lime7git/sun-follower/README.md

# sun-follower
 Academical project of sun follower based on Raspberry Pi Pico.
 
