lime7git/sun-follower/docs/links.txt

Ogniwo słoneczne - https://botland.com.pl/panele-sloneczne-malej-mocy/3695-ogniwo-sloneczne-07w55v-95x95x3mm.html

95x95x3 mm
0.7 W
5.5 V

https://botland.com.pl/serwa-typu-medium/2303-serwo-powerhd-hd-1160a-medium-6953524540047.html
