lime7git/sun-follower/3d-model/renders/1.JPG

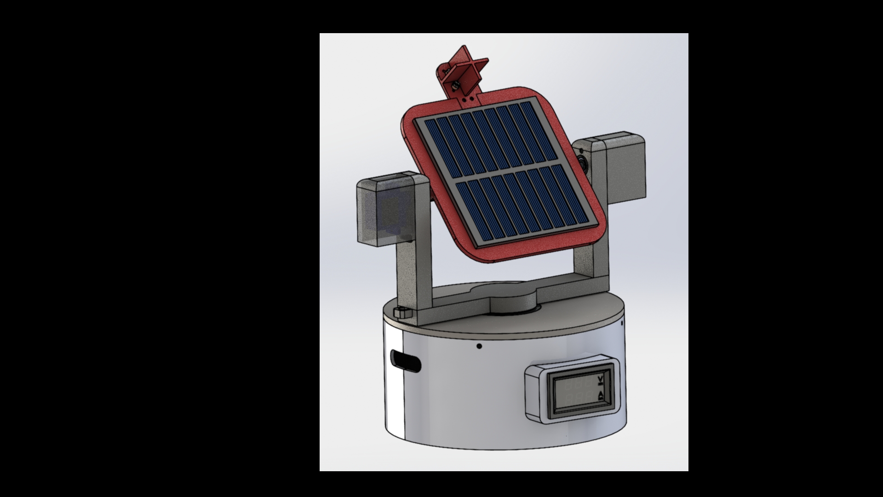
3d-model/renders/1.JPG
