lime7git/sun-follower/3d-model/renders/3.JPG

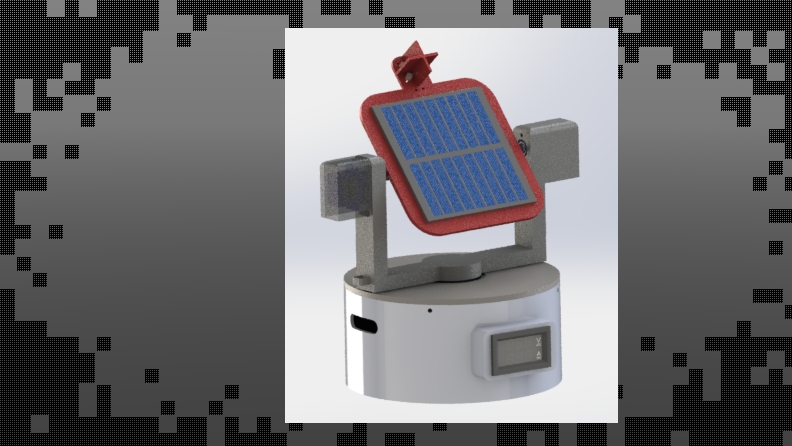
3d-model/renders/3.JPG
