lime7git/sun-follower/docs/adc-multiplexing-circuit.png

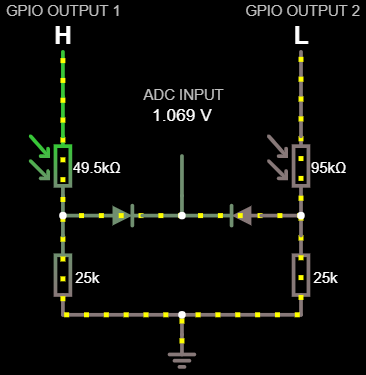
docs/adc-multiplexing-circuit.png
