lime7git/sun-follower/photos/komplet.jpg

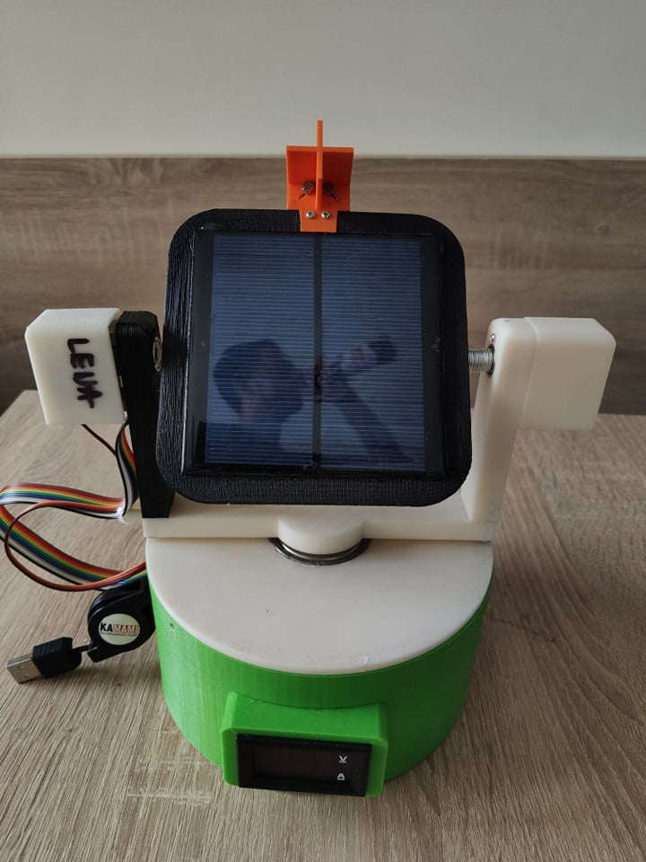
photos/komplet.jpg
