lime7git/sun-follower/photos/kompletny_2.jpg

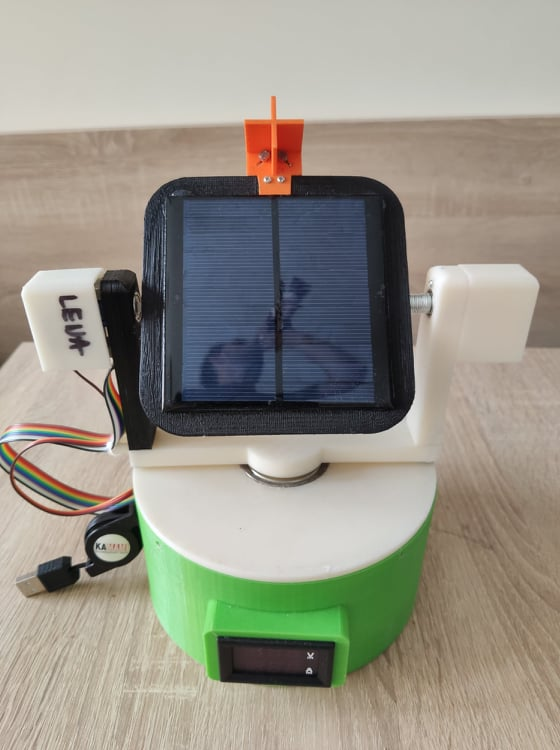
photos/kompletny_2.jpg
