lime7git/sun-follower/3d-model/ramie_prawe.SLDPRT

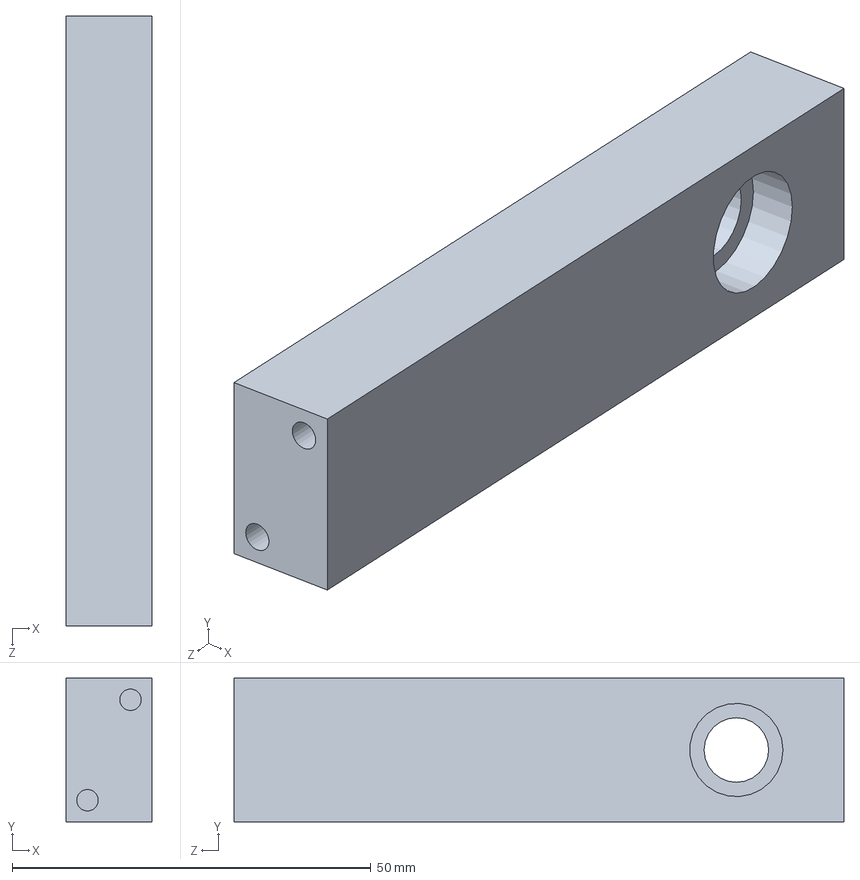
[picture p35: CAD file, 2022-02-01]
3d-model/ramie_prawe.SLDPRT
12.0 x 20.0 x 85.0 mm
