lime7git/sun-follower/3d-model/3d-printing-stl/Nowy folder/walek_lewy.STL

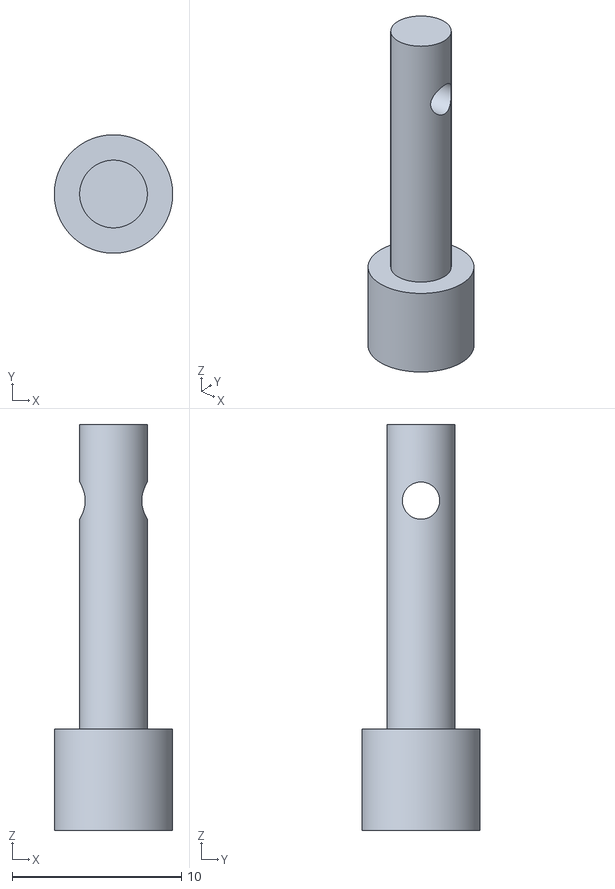
[picture p36: CAD file, 2021-12-16]
3d-model/3d-printing-stl/Nowy folder/walek_lewy.STL
7.00 x 7.00 x 24.0
