lime7git/sun-follower/3d-model/oslona_elektroniki_2.SLDPRT

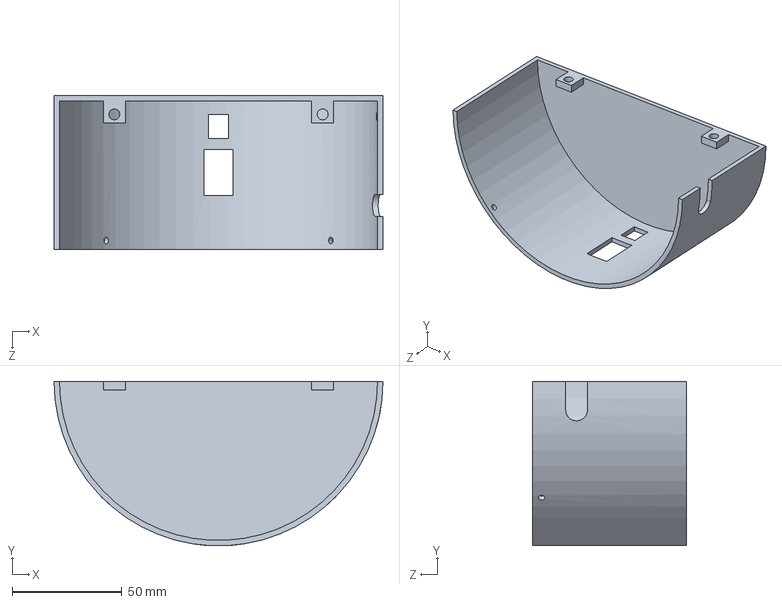
[picture p37: CAD file, 2021-12-21]
3d-model/oslona_elektroniki_2.SLDPRT
150.0 x 74.9 x 70.0 mm
