lime7git/sun-follower/3d-model/3d-printing-stl/Nowy folder/brama.STL

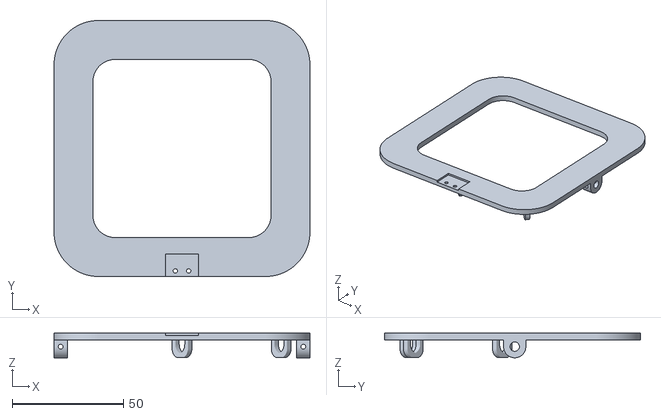
[picture p38: CAD file, 2021-12-16]
3d-model/3d-printing-stl/Nowy folder/brama.STL
115.0 x 115.0 x 11.1
