lime7git/sun-follower/3d-model/oslona_elektroniki_1.SLDPRT

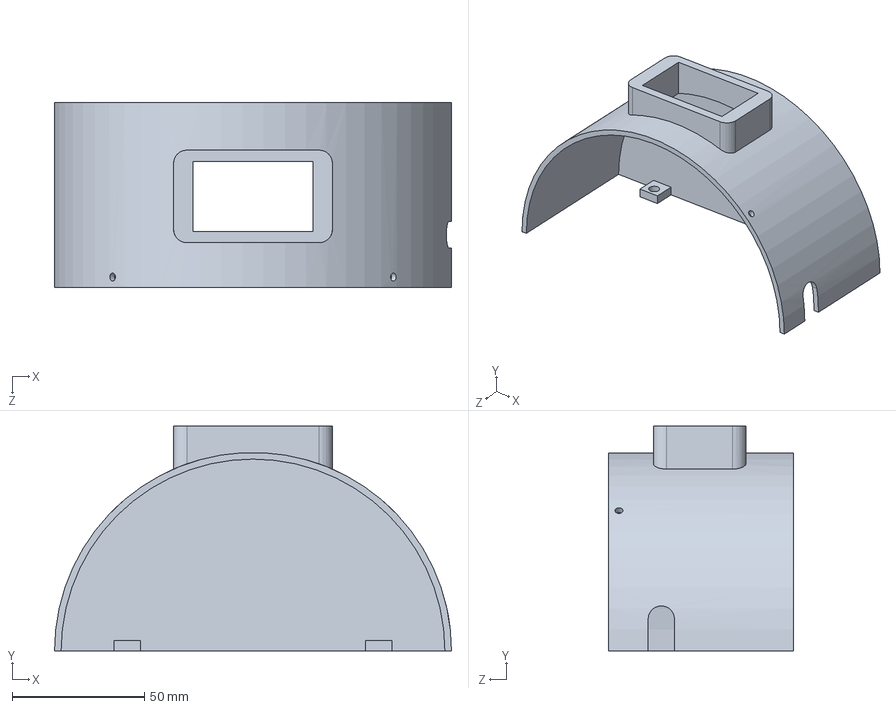
[picture p39: CAD file, 2021-12-21]
3d-model/oslona_elektroniki_1.SLDPRT
150.0 x 85.0 x 70.0 mm
