lime7git/sun-follower/3d-model/3d-printing-stl/Nowy folder/mocowanie.STL

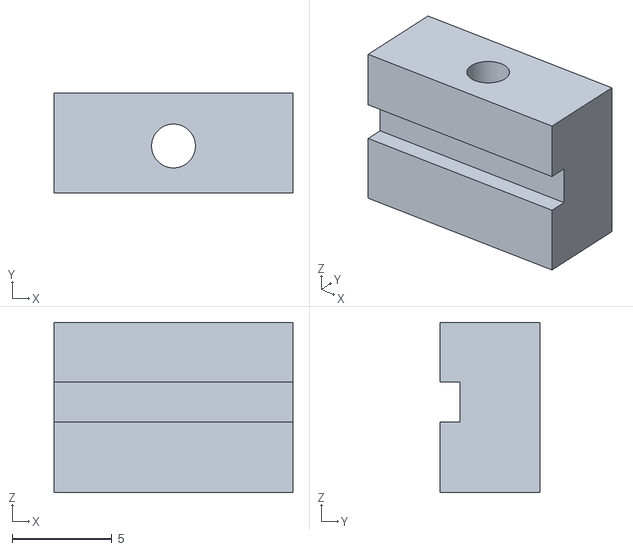
[picture p40: CAD file, 2021-12-02]
3d-model/3d-printing-stl/Nowy folder/mocowanie.STL
12.0 x 5.00 x 8.55
