lime7git/sun-follower/3d-model/podstawa.SLDPRT

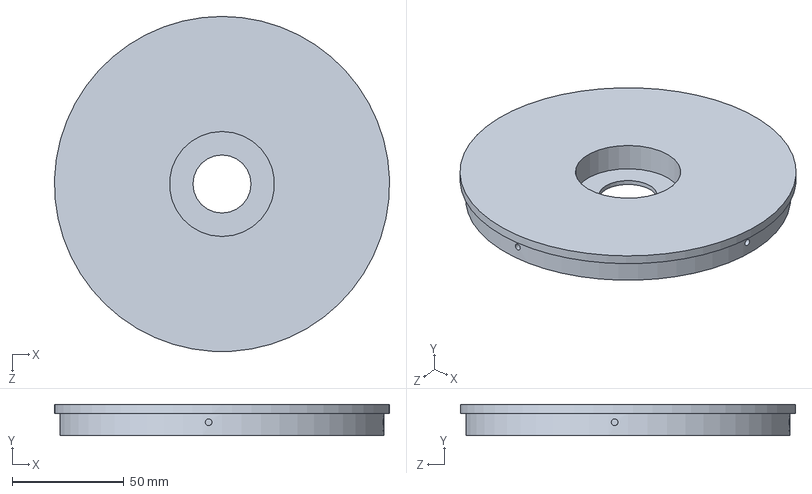
[picture p41: CAD file, 2021-12-18]
3d-model/podstawa.SLDPRT
149.9 x 14.0 x 150.0 mm
