lime7git/sun-follower/3d-model/oslona_elektroniki.SLDPRT

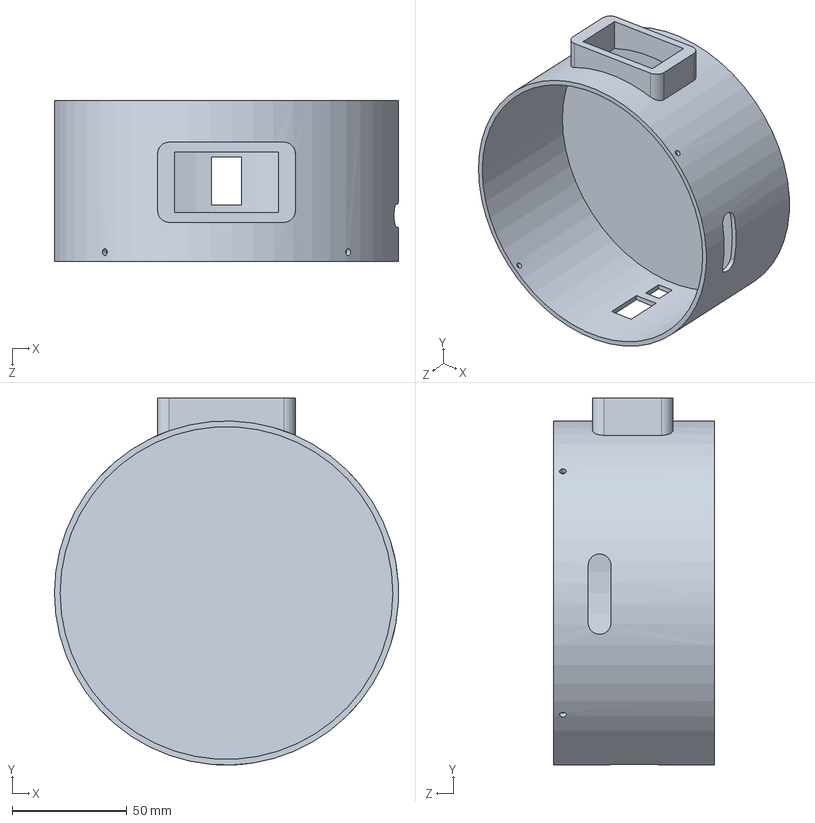
[picture p42: CAD file, 2021-12-18]
3d-model/oslona_elektroniki.SLDPRT
150.0 x 160.0 x 70.0 mm
