lime7git/sun-follower/3d-model/walek_lewy.SLDPRT

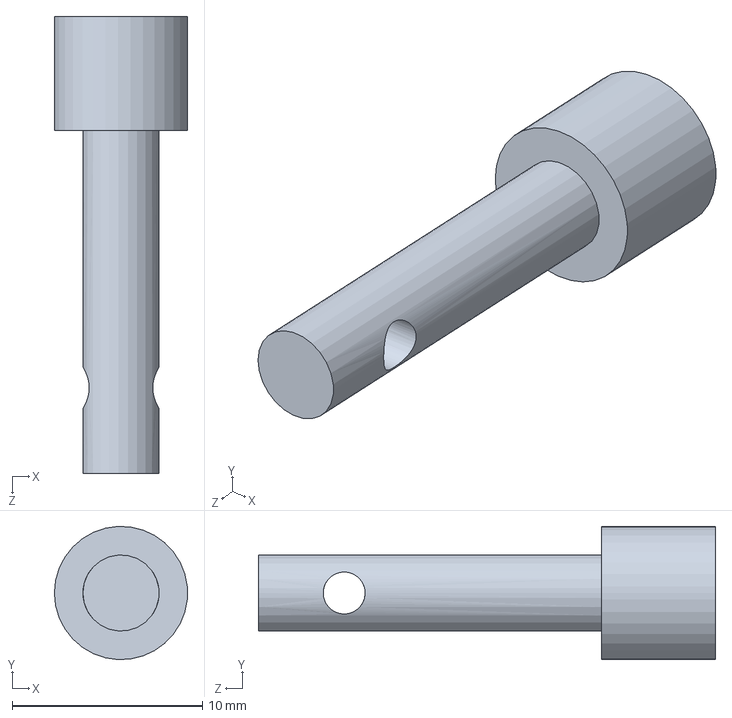
[picture p43: CAD file, 2021-12-16]
3d-model/walek_lewy.SLDPRT
7.00 x 6.99 x 24.0 mm
