lime7git/sun-follower/3d-model/oslona_prawa.SLDPRT

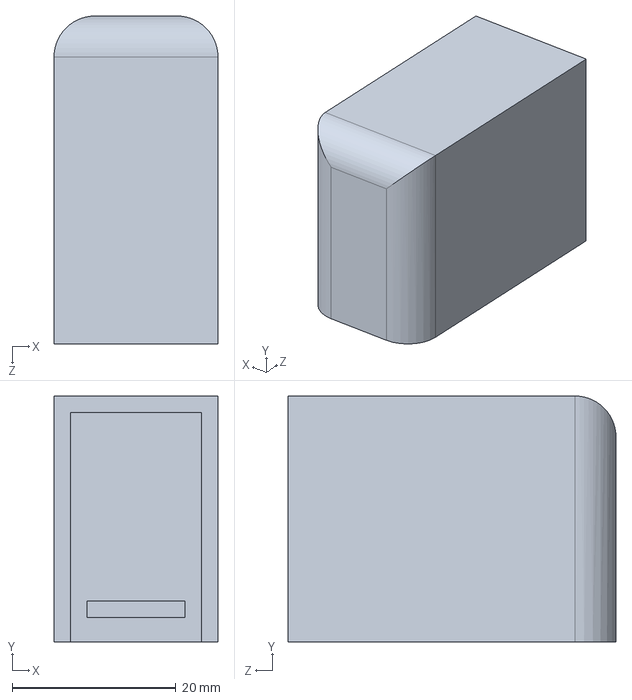
[picture p44: CAD file, 2021-12-02]
3d-model/oslona_prawa.SLDPRT
20.0 x 30.0 x 40.0 mm
