lime7git/sun-follower/3d-model/obrotnica.SLDPRT

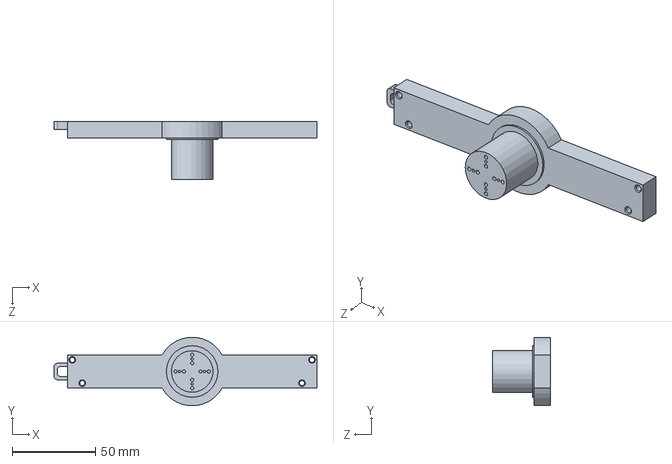
[picture p45: CAD file, 2021-12-02]
3d-model/obrotnica.SLDPRT
158.0 x 41.0 x 35.0 mm
