lime7git/sun-follower/3d-model/serwo-hd-1160A-obrotnica.SLDPRT

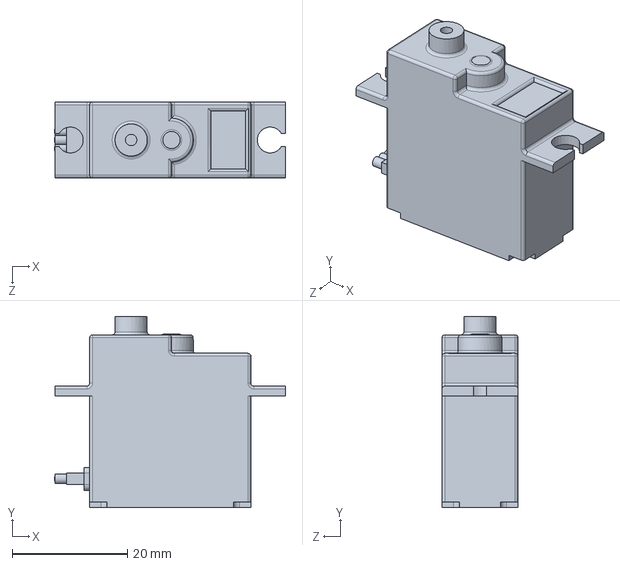
[picture p46: CAD file, 2021-11-12]
3d-model/serwo-hd-1160A-obrotnica.SLDPRT
40.1 x 33.2 x 13.2 mm
