lime7git/sun-follower/3d-model/mocowanie-serwo-obrotnica.SLDPRT

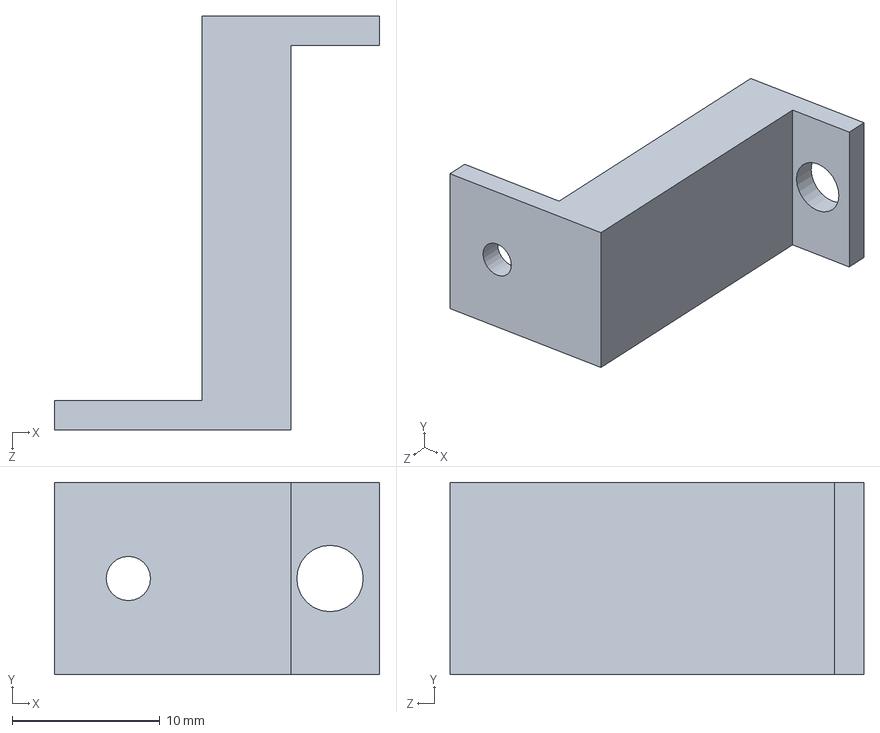
[picture p47: CAD file, 2021-11-12]
3d-model/mocowanie-serwo-obrotnica.SLDPRT
22.0 x 13.0 x 28.0 mm
