lime7git/sun-follower/3d-model/mocowanie-serwo-obrotnica-dluzsze.SLDPRT

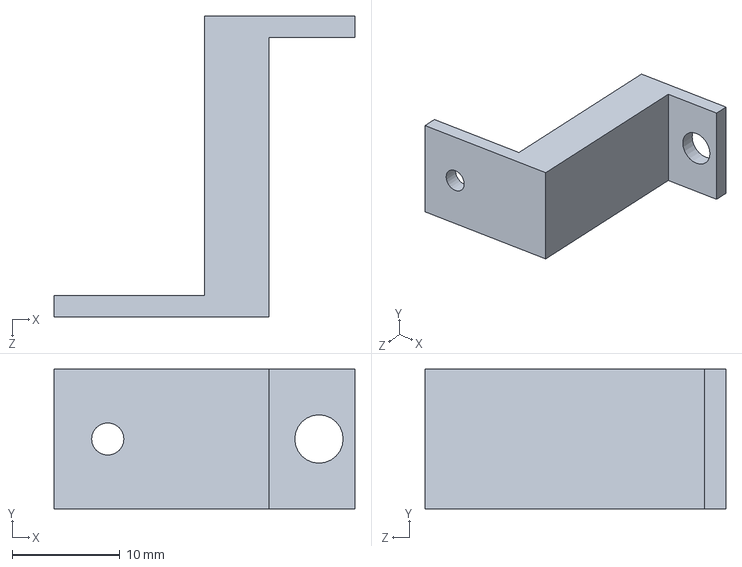
[picture p48: CAD file, 2021-11-12]
3d-model/mocowanie-serwo-obrotnica-dluzsze.SLDPRT
28.0 x 13.0 x 28.0 mm
