lime7git/sun-follower/3d-model/ramie_lewe.SLDPRT

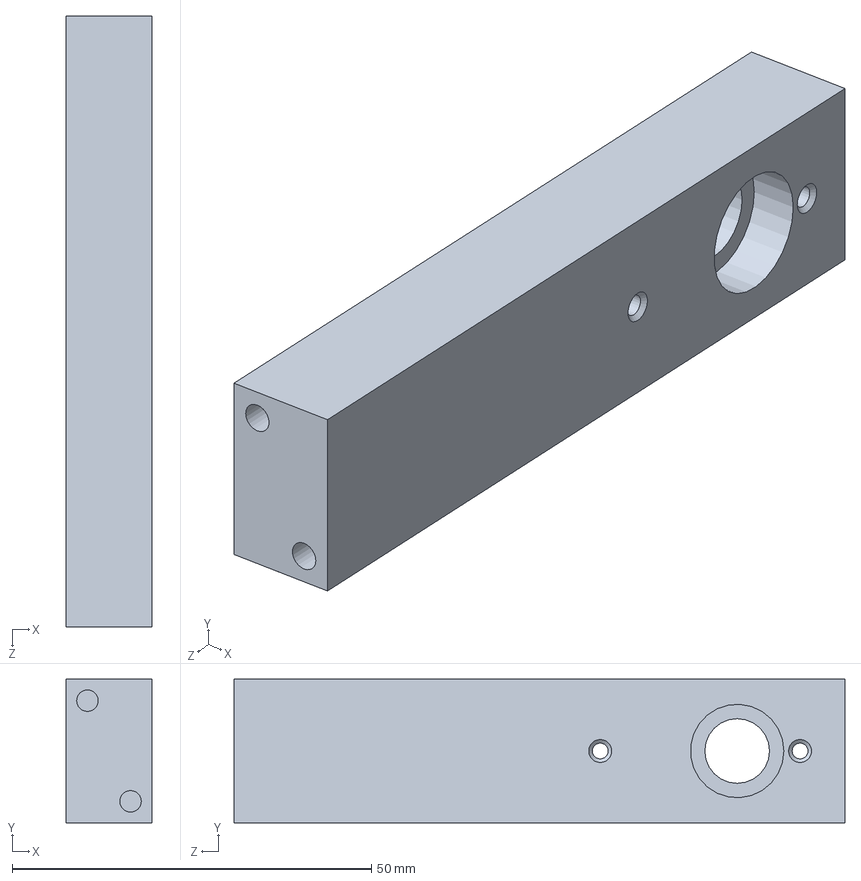
[picture p49: CAD file, 2021-11-12]
3d-model/ramie_lewe.SLDPRT
12.0 x 20.0 x 85.0 mm
