lime7git/sun-follower/3d-model/mocowanie.SLDPRT

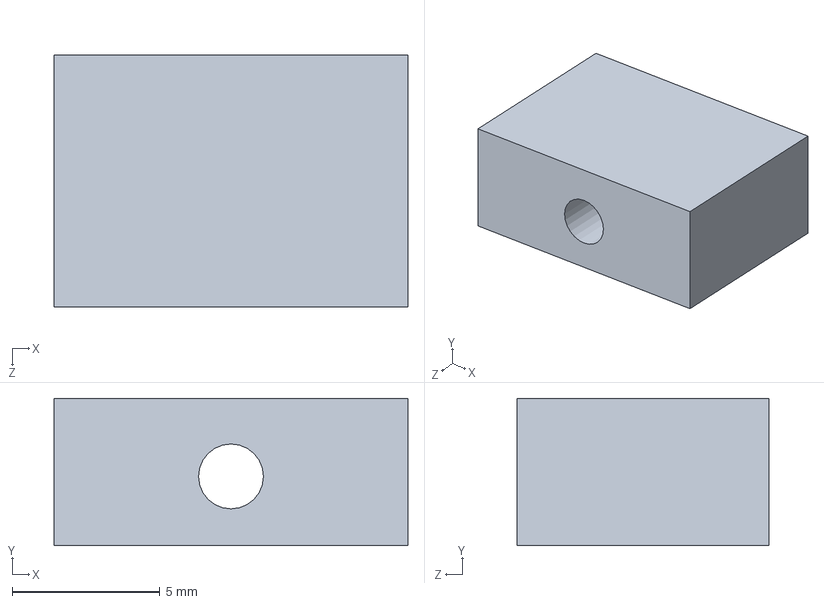
[picture p50: CAD file, 2021-11-09]
3d-model/mocowanie.SLDPRT
12.0 x 5.00 x 8.55 mm
