lime7git/sun-follower/3d-model/przelacznik.SLDPRT

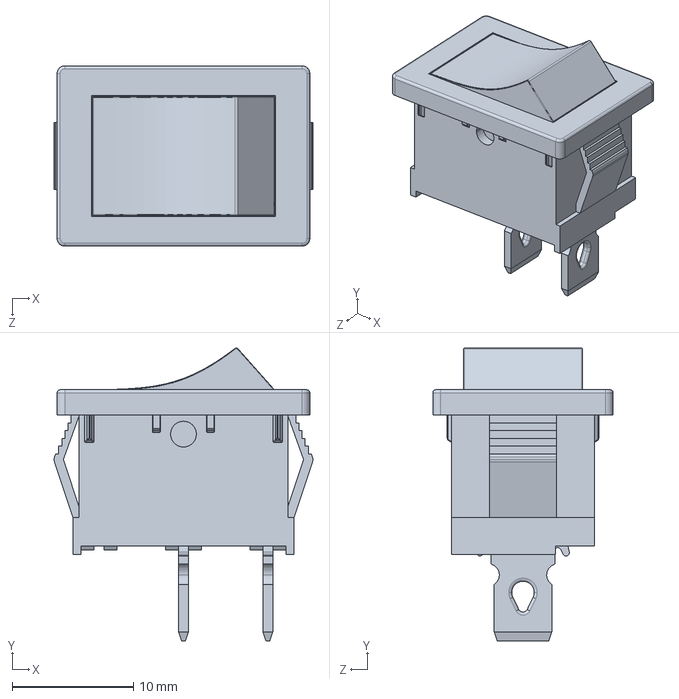
[picture p51: CAD file, 2021-11-09]
3d-model/przelacznik.SLDPRT
21.3 x 24.1 x 14.9 mm
