lime7git/sun-follower/3d-model/konektor-zasilania.SLDPRT

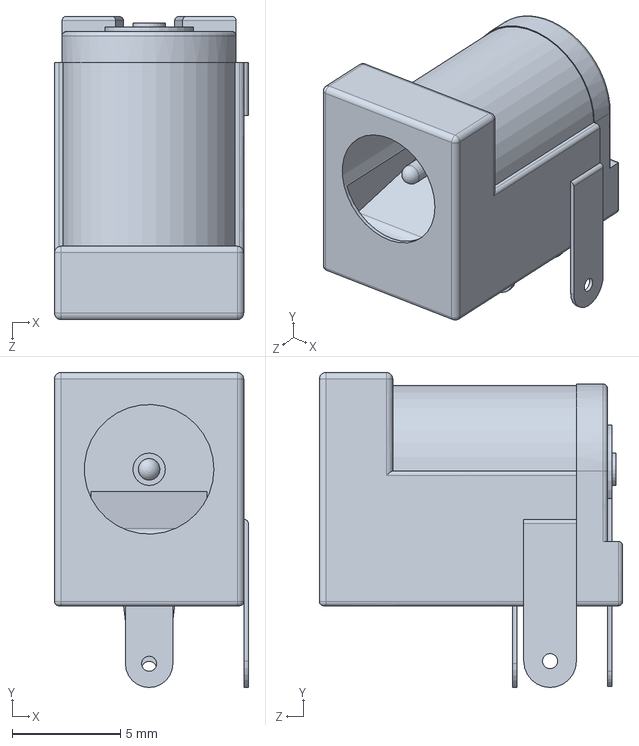
[picture p52: CAD file, 2021-11-09]
3d-model/konektor-zasilania.SLDPRT
8.98 x 14.6 x 14.0 mm
