lime7git/sun-follower/3d-model/woltomierz.SLDPRT

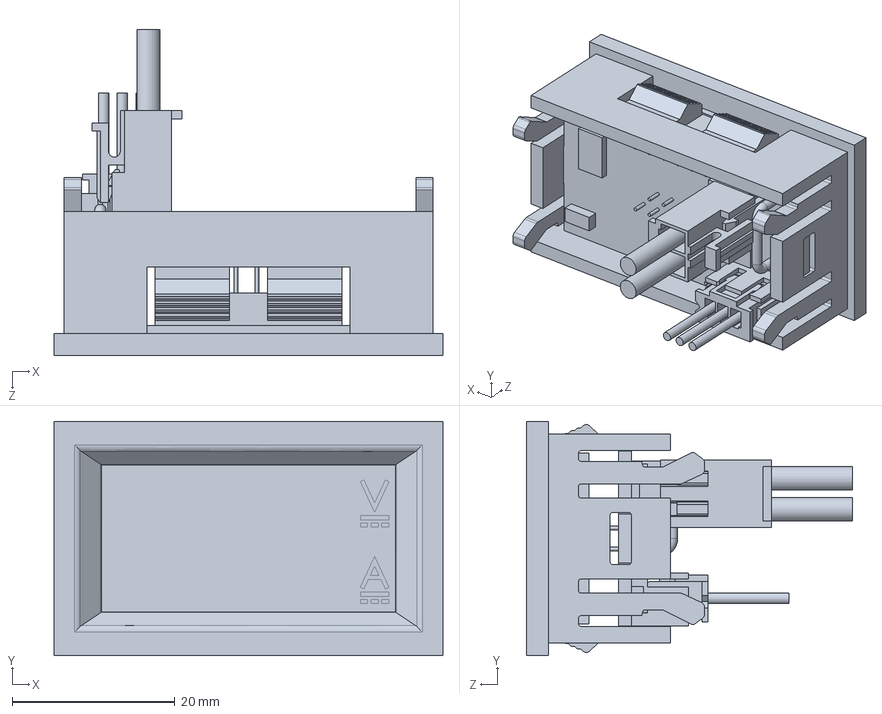
[picture p53: CAD file, 2021-11-08]
3d-model/woltomierz.SLDPRT
47.8 x 28.8 x 40.1 mm
