lime7git/sun-follower/3d-model/czujnik.SLDPRT

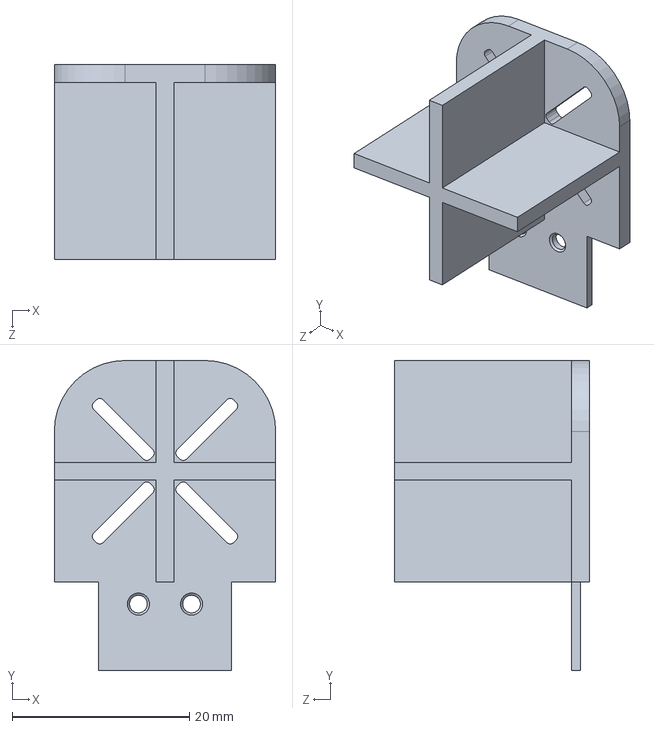
[picture p54: CAD file, 2021-11-08]
3d-model/czujnik.SLDPRT
25.0 x 35.0 x 22.0 mm
