lime7git/sun-follower/3d-model/panel-fotowoltaiczny.SLDPRT

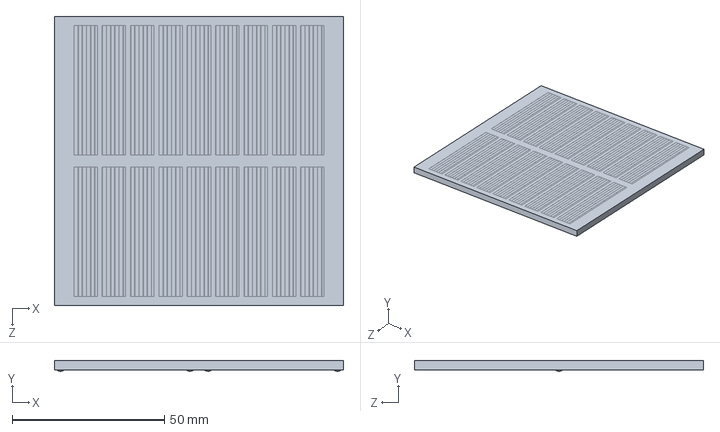
[picture p55: CAD file, 2021-11-08]
3d-model/panel-fotowoltaiczny.SLDPRT
95.0 x 3.51 x 95.0 mm
