lime7git/sun-follower/3d-model/fotorezystor.SLDPRT

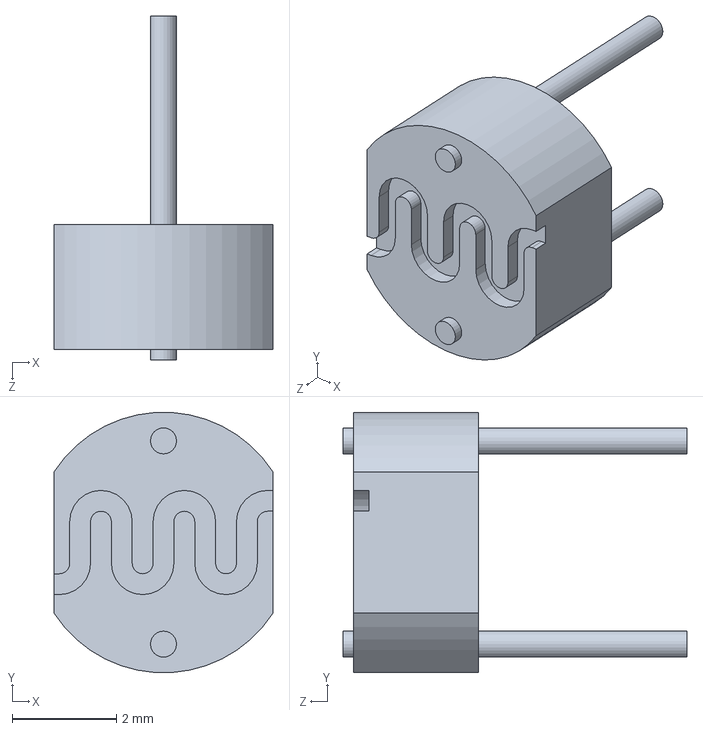
[picture p56: CAD file, 2021-11-04]
3d-model/fotorezystor.SLDPRT
4.20 x 4.99 x 6.60 mm
