lime7git/sun-follower/3d-model/serwo-sg-90-brama.SLDPRT

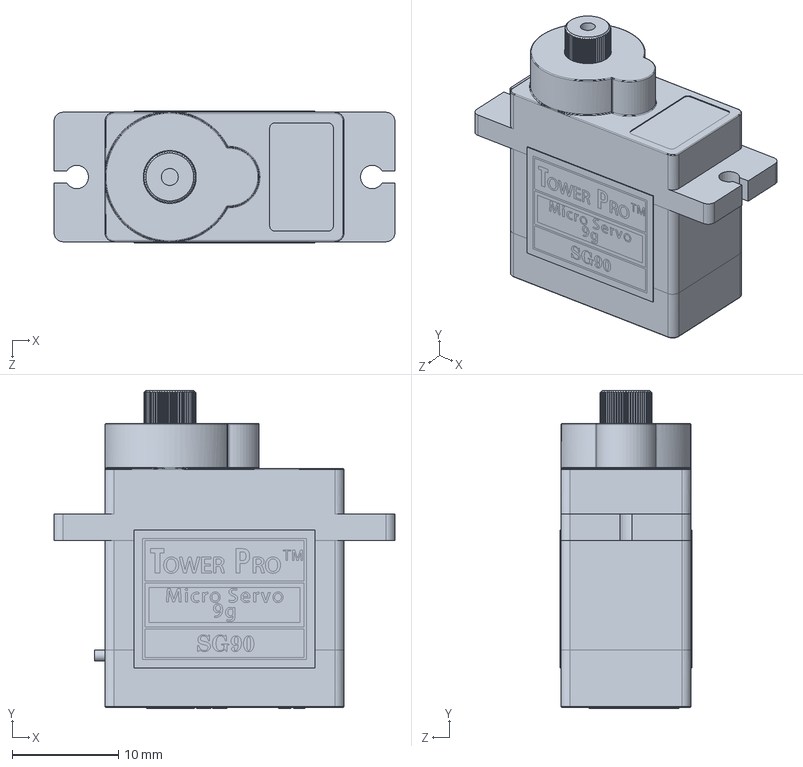
[picture p57: CAD file, 2021-11-04]
3d-model/serwo-sg-90-brama.SLDPRT
32.1 x 30.0 x 12.4 mm
