lime7git/sun-follower/3d-model/lozysko-12mm.SLDPRT

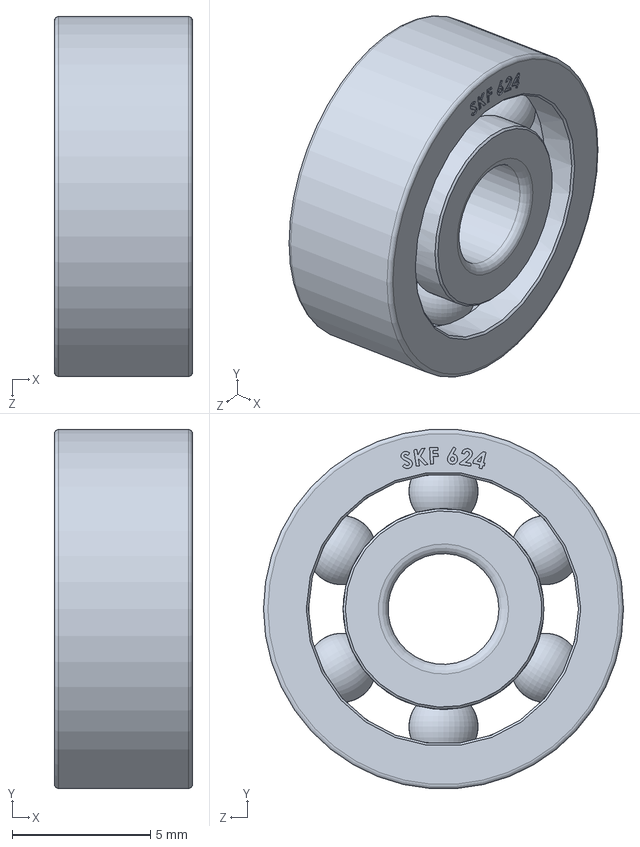
[picture p58: CAD file, 2021-11-03]
3d-model/lozysko-12mm.SLDPRT
5.00 x 13.0 x 13.0 mm
