lime7git/sun-follower/3d-model/lozysko-25mm.SLDPRT

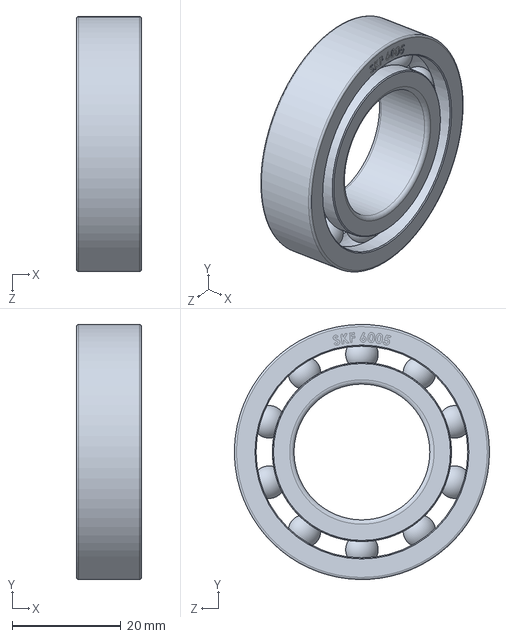
[picture p59: CAD file, 2021-11-03]
3d-model/lozysko-25mm.SLDPRT
12.0 x 47.0 x 47.0 mm
