lime7git/sun-follower/(list of files, cad)

Other CAD files:
3d-model/walek_prawy.SLDPRT
3d-model/brama.SLDPRT
3d-model/osłona_lewa.SLDPRT
3d-model/3d-printing-stl/czujnik.STL
3d-model/3d-printing-stl/mocowanie-serwo-obrotnica-dluzsze.STL
3d-model/3d-printing-stl/mocowanie-serwo-obrotnica.STL
3d-model/3d-printing-stl/obrotnica.STL
3d-model/3d-printing-stl/oslona_elektroniki.STL
3d-model/3d-printing-stl/oslona_elektroniki_1.STL
3d-model/3d-printing-stl/oslona_elektroniki_2.STL
3d-model/3d-printing-stl/oslona_prawa.STL
3d-model/3d-printing-stl/osłona_lewa.STL
3d-model/3d-printing-stl/podstawa.STL
3d-model/3d-printing-stl/ramie_lewe.STL
3d-model/3d-printing-stl/ramie_prawe.STL
schematic/sun-follower/pi_pico_footprint/KiCad-RP-Pico-main/SketchUp Model/Pico.skp
