lime7git/sun-follower/schematic/sun-follower/sun-follower.kicad_pcb

## KiCad design schematic/sun-follower/sun-follower.kicad_pcb (2022-01-19)

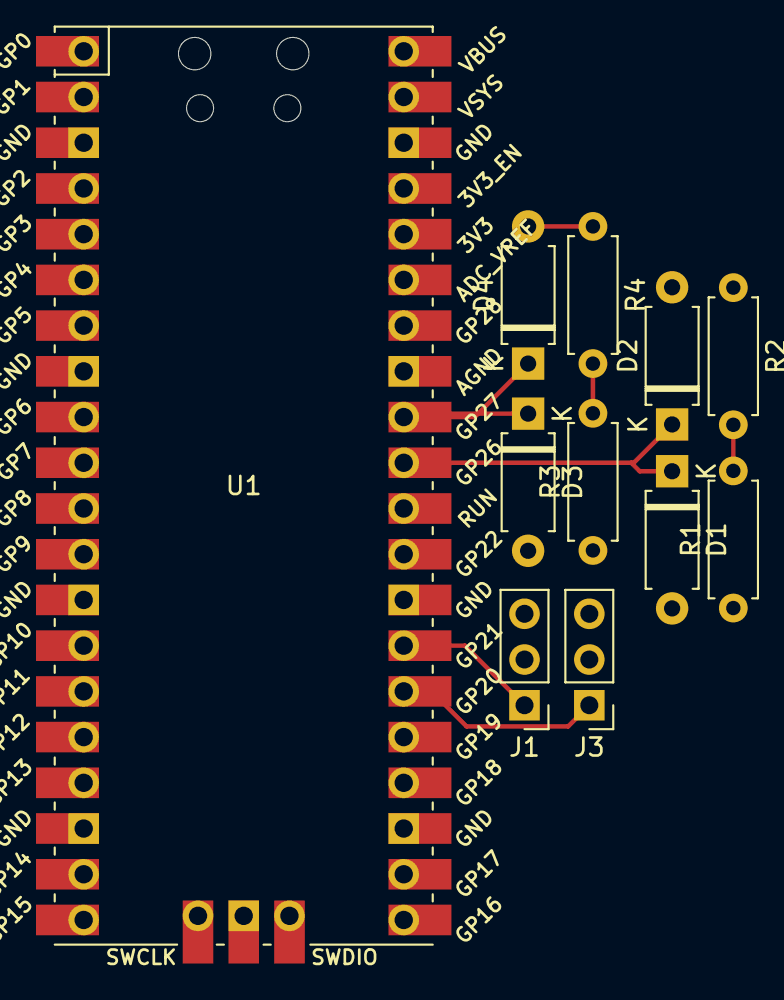
[picture p73: board sun-follower.kicad_pcb from above]

Board: 2 copper layers, 11 parts (0 on the bottom side), 10 nets.

Parts:
D1, D2, D3, D4: 1N4148; D_A-405_P7.62mm_Horizontal
J1, J3: SERWO_1; PinHeader_1x03_P2.54mm_Vertical
R1, R2, R3, R4: R; R_Axial_DIN0207_L6.3mm_D2.5mm_P7.62mm_Horizontal
U1: Pico; RPi_Pico_SMD_TH

Connections:
+5V: J1.2, J3.2
ADC_0: D1.1, D2.1, U1.31
ADC_1: D3.1, D4.1, U1.32
GND: J1.3, J3.3, R1.2, R2.2, R3.2, R4.2, U1.3, U1.8, U1.13, U1.18, U1.23, U1.28, U1.33, U1.38, U1.42
unnamed: D1.2, R1.1
unnamed: D2.2, R2.1
unnamed: D3.2, R3.1
unnamed: D4.2, R4.1
PWM1: J1.1, U1.27
PWM2: J3.1, U1.26
