lime7git/sun-follower/schematic/sun-follower/pi_pico_footprint/KiCad-RP-Pico-main/Test/Test.kicad_pcb

## KiCad design schematic/sun-follower/pi_pico_footprint/KiCad-RP-Pico-main/Test/Test.kicad_pcb (2022-01-19)

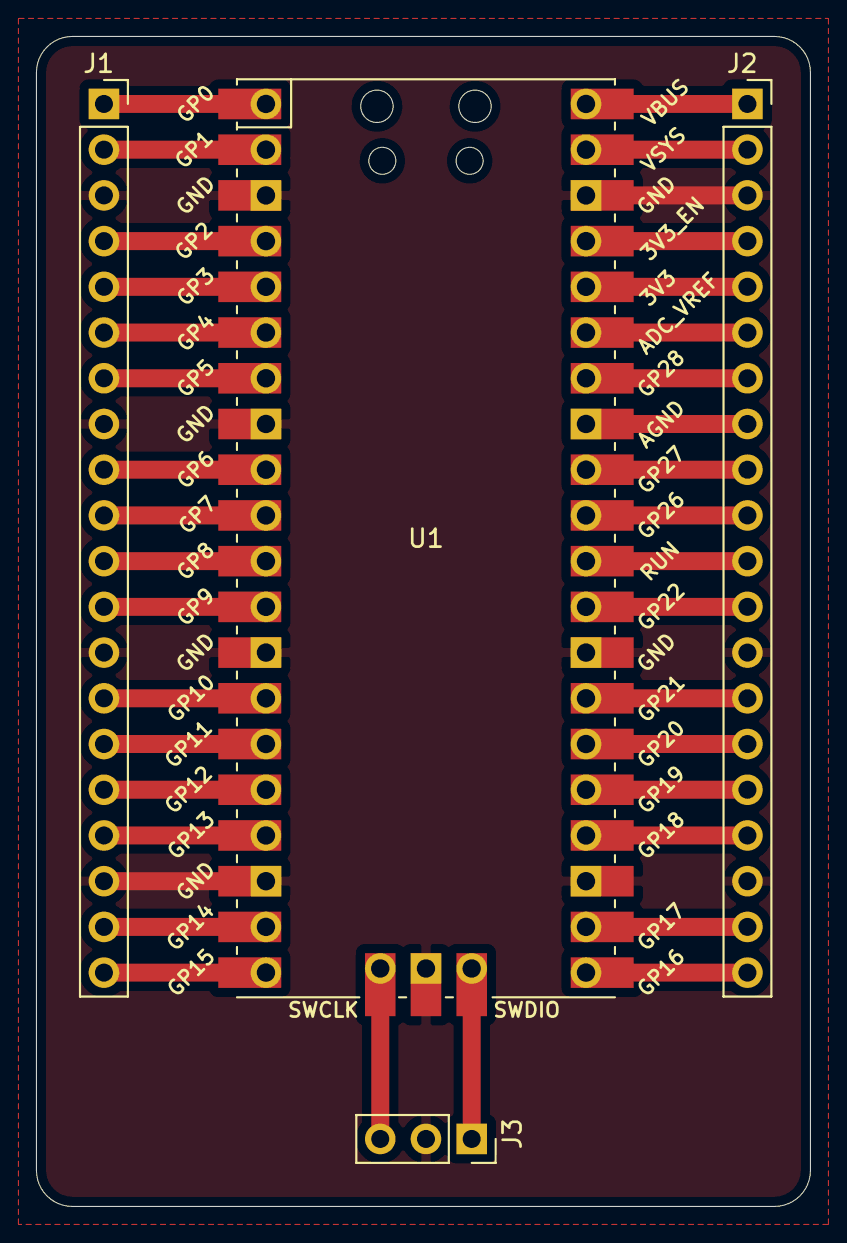
[picture p74: board Test.kicad_pcb from above]

Board: 2 copper layers, 43.0 x 65.0 mm, 4 parts (0 on the bottom side), 36 nets.

Parts:
J1, J2: Conn_01x20; PinSocket_1x20_P2.54mm_Vertical
J3: Conn_01x03; PinSocket_1x03_P2.54mm_Vertical
U1: Pico; RPi_Pico_SMD_TH

Connections:
GND: J1.3, J1.8, J1.13, J1.18, J2.3, J2.13, J2.18, J3.2, U1.3, U1.8, U1.13, U1.18, U1.23, U1.28, U1.38, U1.42
unnamed: J1.1, U1.1
unnamed: J1.2, U1.2
unnamed: J1.4, U1.4
unnamed: J1.5, U1.5
unnamed: J1.6, U1.6
unnamed: J1.7, U1.7
unnamed: J1.9, U1.9
unnamed: J1.10, U1.10
unnamed: J1.11, U1.11
unnamed: J1.12, U1.12
unnamed: J1.14, U1.14
unnamed: J1.15, U1.15
unnamed: J1.16, U1.16
unnamed: J1.17, U1.17
unnamed: J1.19, U1.19
unnamed: J1.20, U1.20
unnamed: J2.1, U1.40
unnamed: J2.2, U1.39
unnamed: J2.4, U1.37
unnamed: J2.5, U1.36
unnamed: J2.6, U1.35
unnamed: J2.7, U1.34
unnamed: J2.8, U1.33
unnamed: J2.9, U1.32
unnamed: J2.10, U1.31
unnamed: J2.11, U1.30
unnamed: J2.12, U1.29
unnamed: J2.14, U1.27
unnamed: J2.15, U1.26
unnamed: J2.16, U1.25
unnamed: J2.17, U1.24
unnamed: J2.19, U1.22
unnamed: J2.20, U1.21
unnamed: J3.1, U1.43
unnamed: J3.3, U1.41
