lime7git/sun-follower/(commit log)

2021-11-04 Add some changes
    [brama.SLDPRT, czujnik.SLDPRT, fotorezystor_.SLDPRT, obrotnica.SLDPRT, orczyk-sg-90.SLDPRT, serwo-sg-90-brama.SLDPRT, walek.SLDPRT]
2021-11-08 Added some changes
    [brama.SLDPRT, czujnik.SLDPRT, obrotnica.SLDPRT, panel-fotowoltaiczny.SLDPRT, ramie_lewe.SLDPRT, ramie_prawe.SLDPRT, solar-panel.SLDPRT, stol.SLDPRT]
2021-11-08 Design of electronic case
    [oslona_elektroniki.SLDPRT, podstawa.SLDPRT, ramie_lewe.SLDPRT]
2021-11-08 Adding whole for digital voltometer
    [oslona_elektroniki.SLDPRT]
2021-11-08 Added voltometer
    [woltomierz.SLDPRT]
2021-11-08 Final ver. 1.0
    [ramie_lewe.SLDPRT]
2021-11-09 Added some new 3D models
    [Część1.SLDPRT, konektor-zasilania.SLDPRT, mocowanie.SLDPRT, podstawa.SLDPRT, przelacznik.SLDPRT, ramie_lewe.SLDPRT, ramie_prawe.SLDPRT, serwo-obrotnica.SLDPRT]
2021-11-10 Servo cases and cable holders + some small stuff
    [Część1.SLDPRT, brama.SLDPRT, obrotnica.SLDPRT, oslona_elektroniki.SLDPRT, oslona_prawa.SLDPRT, osłona_lewa.SLDPRT, ramie_lewe.SLDPRT, ramie_prawe.SLDPRT]
2021-11-12 Added new bottom servo and its holders, done some small fixes
    [mocowanie-serwo-obrotnica-dluzsze.SLDPRT, mocowanie-serwo-obrotnica.SLDPRT, oslona_elektroniki.SLDPRT, podstawa.SLDPRT, ramie_lewe.SLDPRT, ramie_prawe.SLDPRT, serwo-hd-1160A-obrotnica.SLDPRT, serwo-obrotnica.SLDPRT]
2021-11-16 Small changes
    [oslona_elektroniki.STL]
2021-12-02 Added STL files to 3D printing
    [brama.STL, czujnik.STL, obrotnica.STL, ramie_lewe.STL, ramie_prawe.STL]
2021-12-02 Change wires holders
    [brama.SLDPRT]
2021-12-02 Added all stl files
    [mocowanie-serwo-obrotnica-dluzsze.STL, mocowanie-serwo-obrotnica.STL, mocowanie.STL, obrotnica.STL, oslona_prawa.STL, osłona_lewa.STL, podstawa.STL, walek_lewy.STL]
2021-12-02 Small edits
    [fotorezystor.SLDPRT, obrotnica.SLDPRT, orczyk-sg-90.SLDPRT, oslona_prawa.SLDPRT]
2021-12-21 Some case changes
    [oslona_elektroniki_1.SLDPRT, oslona_elektroniki_1.STL, oslona_elektroniki_2.SLDPRT, oslona_elektroniki_2.STL]
2022-02-03 corrections_of_project
    to print
